vtx22/siemens-vehicle/README.md

# PCB | Siemens Projekt 2021/2022
Dokumentation für das PCB des Fahrzeugs, das im Rahmen der Projektarbeit der Siemens Ausbildung entstanden ist.
