vtx22/siemens-vehicle/Altium Projekt/SiemensKarre/Project Outputs for SiemensKarre/SiemensKarre.xlsx

Comment | Description | Designator | Footprint | LibRef | Quantity
220uF | Capacitor Polarised | C1, C3, C24 | CAPAE830X650N | EEE-FK1A221P | 3
10nF | Capacitor | C2, C4, C10, C21, C26, C29, C34 | CAPC2012 METRIC | CL21B104KACNNNC | 7
100nF | Capacitor | C5, C6, C11, C12, C13, C14, C19, C22, C27, C30, C31, C33, C36, C38, C42 | CAPC2012 METRIC | CL21B104KACNNNC | 15
22pF | Capacitor | C7, C8 | CAPC2012 METRIC | CL21B104KACNNNC | 2
1uF | Capacitor | C9 | CAPC2012 METRIC | CL21B104KACNNNC | 1
4.7uF | Capacitor | C15 | CAPC2012 METRIC | CL21B104KACNNNC | 1
10pF | Capacitor | C16, C17 | CAPC2012 METRIC | CL21B104KACNNNC | 2
10uF | Capacitor | C18, C20, C40 | CAPC2012 METRIC | CL21B104KACNNNC | 3
47uF | Capacitor | C23 | CAPC2012 METRIC | CL21B104KACNNNC | 1
120uF | Capacitor Polarised | C25 | CAPAE830X650N | EEE-FK1A221P | 1
330uF | Capacitor Polarised | C28 | CAPAE830X650N | EEE-FK1A221P | 1
1000uF | Capacitor Polarised | C32 | CAPAE830X650N | EEE-FK1A221P | 1
100uF | Capacitor Polarised | C35 | CAPAE830X650N | EEE-FK1A221P | 1
PDS1040L-13 | Diode | D1, D2, D3, D4, D5 | POWERDI5 | PDS1040L-13 | 5
1N5819 | Diode | D6 | SOD3716X145N | 1N5819HW-7-F | 1
PESD5V0U1BA,115 | Diode ESD (Bi-directional) | D7 | PESD1IVN27AX | PESD5V0U1BA,115 | 1
LM2678S-5.0_NOPB | Integrated Circuit | IC1 | TO127P1435X464-8N | LM2678S-5.0_NOPB | 1
STM32F103C8T6 | Integrated Circuit | IC2 | QFP50P900X900X160-48N | STM32F103C8T6TR | 1
AMS1117-3.3 | Integrated Circuit | IC3 | SOT229P700X180-4N | AMS1117-3.3 | 1
LM2596S-ADJ_NOPB | Integrated Circuit | IC4 | LM2596SXADJ | LM2596S-ADJ_NOPB | 1
LM2587S-ADJ | Integrated Circuit | IC5 | TO170P1435X465-6N | LM2587S-ADJ_NOPB | 1
DS18B20 | Integrated Circuit | IC6 | DS18B20TR | DS18B20+T&R | 1
INA226AIDGST | Integrated Circuit | IC7 | SOP50P490X110-10N | INA226AIDGST | 1
FT232RL | Integrated Circuit | IC8 | SOP65P778X200-28N | FT232RL | 1
BC846BLT1G | Integrated Circuit | IC10 | SOT96P237X111-3N | BC846BLT1G | 1
Battery IN | Connector | J1 | XT30PB | XT30PB | 1
To Motor PCB | Connector | J2 | XT30PB | XT30PB | 1
5V | Connector | J3, J4, J5 | 2 Pin Header BIG PADS | 2 Pin Header Big Pad | 3
ADJ | Connector | J6, J7 | 2 Pin Header BIG PADS | 2 Pin Header Big Pad | 2
BAT | Connector | J8 | 2 Pin Header BIG PADS | 2 Pin Header Big Pad | 1
24V | Connector | J9, J10 | 2 Pin Header BIG PADS | 2 Pin Header Big Pad | 2
Charger IN | Connector | J11 | 2 Pin Header BIG PADS | 2 Pin Header Big Pad | 1
Charger OUT | Connector | J12 | 2 Pin Header BIG PADS | 2 Pin Header Big Pad | 1
5V ON/OFF | Connector | J13 | 2 Pin Header BIG PADS | 2 Pin Header Big Pad | 1
UART1 | Connector | J14 | 2 Pin Header BIG PADS | 2 Pin Header Big Pad | 1
BOOT SELECT | Connector | J15 | HDRV3W64P0X254_1X3_762X254X869P | 61300311121 | 1
PROG | Connector | J16 | HDRV3W64P0X254_1X3_762X254X869P | 61300311121 | 1
UART3 | Connector | J17 | 2 Pin Header BIG PADS | 2 Pin Header Big Pad | 1
I2C1 | Connector | J18, J24 | 2 Pin Header BIG PADS | 2 Pin Header Big Pad | 2
LEDS1 | Connector | J19 | HDRV3W64P0X254_1X3_762X254X869P | 61300311121 | 1
ADCs | Connector | J20 | HDRV3W64P0X254_1X3_762X254X869P | 61300311121 | 1
USB Power | Connector | J21 | 875200010BLF | 87520-0010BLF | 1
Micro USB Port | Connector | J26 | 101041100001LF | Micro USB Port | 1
GPIOs | Connector | J28 | HDRV4W95P0X254_1X4_1016X254X854P | 61300411121 | 1
ULTRA1 | Connector | J29, J30 | HDRV4W95P0X254_1X4_1016X254X854P | 61300411121 | 2
VCC | Connector | J31 | 2 Pin Header BIG PADS | 2 Pin Header Big Pad | 1
Main Switch | Connector | J32 | 2 Pin Header BIG PADS | 2 Pin Header Big Pad | 1
G5NB-1A-E_5DC | Relay or Contactor | K1 | G5NB1A4DC5 | G5NB-1A-E_5DC | 1
SRP1270-100M | Inductor | L1 | INDPM137137X700N | SRP1270-100M | 1
39nH | Chip Bead, 100 MHz, 5 A, -40 to 125 degC, 2-Pin SMD (0805), RoHS, Tape and Reel | L2 | LIRD-LI0805H151R-10-2_V | CMP-2000-06404-1 | 1
IHLP6767GZER470M11 | Inductor | L3, L4 | INDPM172172X700N | IHLP6767GZER470M11 | 2
5V Green | SMD mono-color Chip LED, WL-SMCW, Green | LED1 | 1206_A | CMP-1426-00014-1 | 1
12V Green | SMD mono-color Chip LED, WL-SMCW, Green | LED2 | 1206_A | CMP-1426-00014-1 | 1
24V Green | SMD mono-color Chip LED, WL-SMCW, Green | LED3 | 1206_A | CMP-1426-00014-1 | 1
BAT Yell | SMD mono-color Chip LED, WL-SMCW, Green | LED4 | 1206_A | CMP-1426-00014-1 | 1
Stat1 | SMD mono-color Chip LED, WL-SMCW, Green | LED5 | 1206_A | CMP-1426-00014-1 | 1
Stat2 | SMD mono-color Chip LED, WL-SMCW, Green | LED6 | 1206_A | CMP-1426-00014-1 | 1
BAT Red | SMD mono-color Chip LED, WL-SMCW, Green | LED7, LED8 | 1206_A | CMP-1426-00014-1 | 2
Green | SMD mono-color Chip LED, WL-SMCW, Green | LED11 | 1206_A | CMP-1426-00014-1 | 1
190 | Resistor | R1 | RESC2012X65N | Res 0805 | 1
890 | Resistor | R2 | RESC2012X65N | Res 0805 | 1
2090 | Resistor | R3 | RESC2012X65N | Res 0805 | 1
1510 | Resistor | R4, R5, R6 | RESC2012X65N | Res 0805 | 3
47k | Resistor | R7, R11 | RESC2012X65N | Res 0805 | 2
15k | Resistor | R8, R41 | RESC2012X65N | Res 0805 | 2
2k | Resistor | R9 | RESC2012X65N | RMCF0805ZT0R00 | 1
24k | Resistor | R10 | RESC2012X65N | Res 0805 | 1
7.5k | Resistor | R12, R16, R17, R27 | RESC2012X65N | Res 0805 | 4
3.9k | Resistor | R13, R46 | RESC2012X65N | Res 0805 | 2
200k | Resistor | R14 | RESC2012X65N | RMCF0805ZT0R00 | 1
9.1k | Resistor | R15 | RESC2012X65N | Res 0805 | 1
10k | Resistor | R18, R20, R21, R24 | RESC2012X65N | RMCF0805ZT0R00 | 4
330 | Resistor | R19 | RESC2012X65N | RMCF0805ZT0R00 | 1
0 | Resistor | R22, R37 | RESC2012X65N | RMCF0805ZT0R00 | 2
390 | Resistor | R23 | RESC2012X65N | RMCF0805ZT0R00 | 1
4.7k | Resistor | R25, R26, R28, R32 | RESC2012X65N | RMCF0805ZT0R00 | 4
350 | Resistor | R29 | RESC2012X65N | RMCF0805ZT0R00 | 1
100 | Resistor | R30 | RESC2012X65N | RMCF0805ZT0R00 | 1
10m | Resistor | R31 | RESC5025X88N | WSL2010R0100FEA18 | 1
28k | Resistor | R33 | RESC2012X65N | Res 0805 | 1
1.5k | Resistor | R34, R44, R45 | RESC2012X65N | Res 0805 | 3
2.94k | Resistor | R35 | RESC2012X65N | Res 0805 | 1
500 | Resistor | R38, R39 | RESC2012X65N | RMCF0805ZT0R00 | 2
1k | Resistor | R42 | RESC2012X65N | Res 0805 | 1
300 | Resistor | R43 | RESC2012X65N | Res 0805 | 1
SMDButton |  | SW1 | SMD-Button-3*6mm | SMDButton-3*6mm | 1
10kOhm Trimmer | Variable Resistor | VR1 | 3296W-1 | 3296W-1-103LF | 1
MC-306 32.768kHz | Crystal or Oscillator | Y1 | MC306327680KA3ROHS | MC-306_32.7680K-A3_ROHS | 1
FOXSDLF/080-20 | Resistance Weld Crystal, 8 MHz, +/- 30 ppm, -20 to 70 degC, 2-Pin SMD, RoHS, Tape and Reel | Y2 | FOX-HC49SDLF_V | CMP-2100-03639-1 | 1
