vtx22/siemens-vehicle/Altium Projekt/SiemensKarre/Outline.dxf

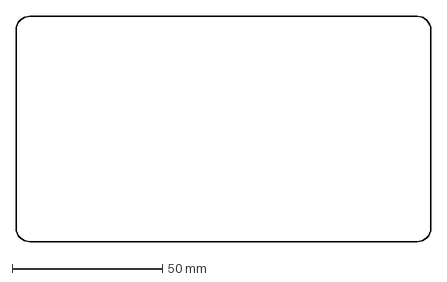
[picture p1: CAD file, 2022-01-15]
Altium Projekt/SiemensKarre/Outline.dxf
138.0 x 75.0 mm
