vtx22/siemens-vehicle/Dokumentation/Schematics.pdf

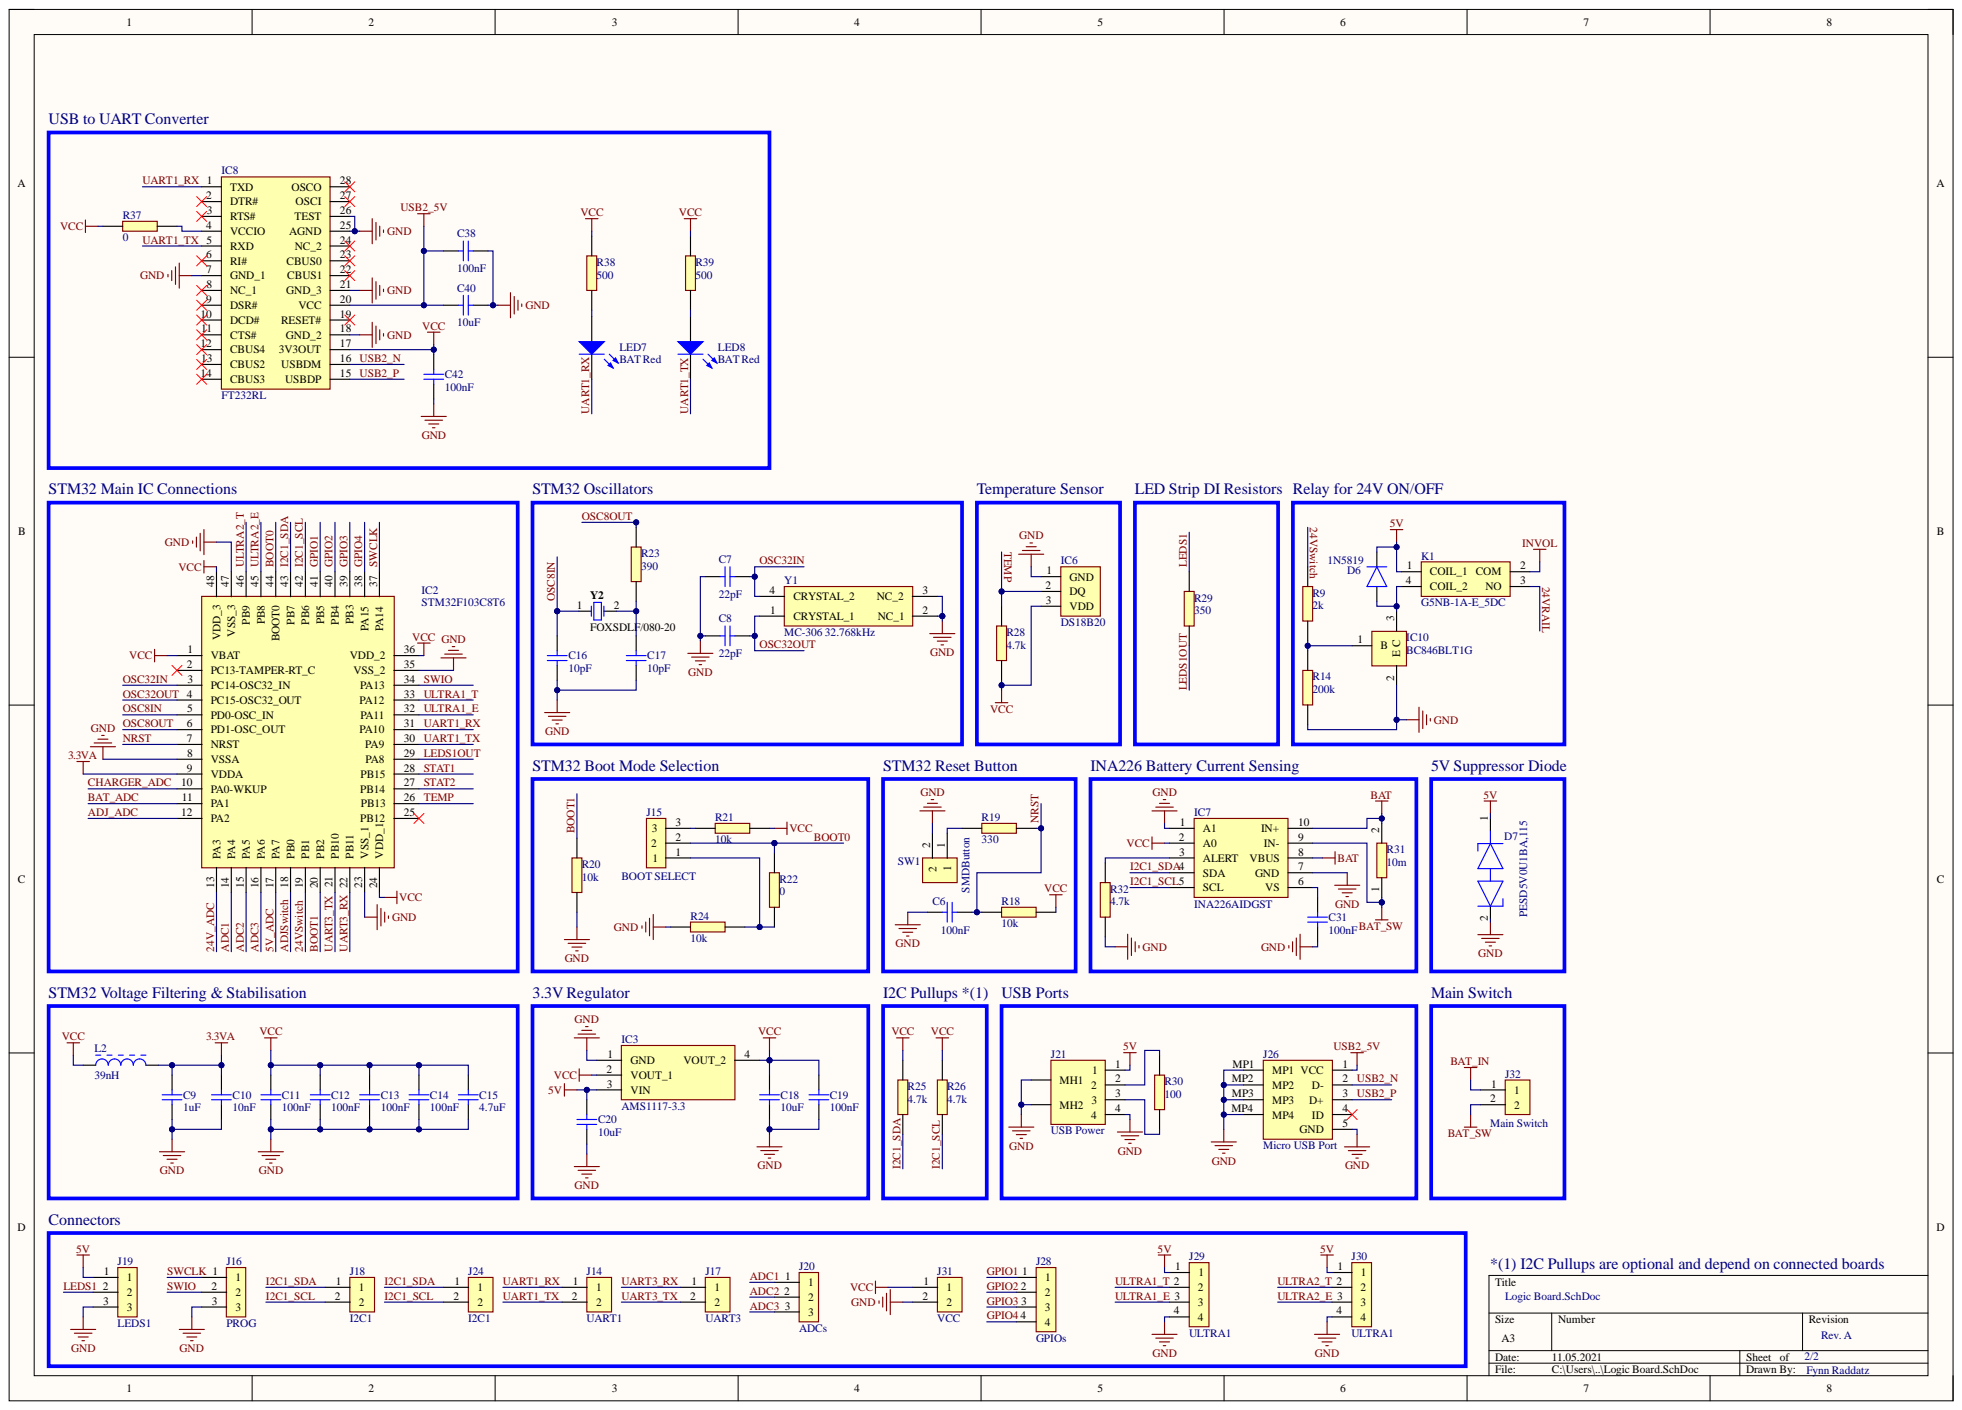
[picture p2: page 1]

USB to UART Converter

LED Strip DI Resistors

Relay for 24V ON/OFF

*(1) I2C Pullups are optional and depend on connected boards
Title
Logic Board.SchDoc

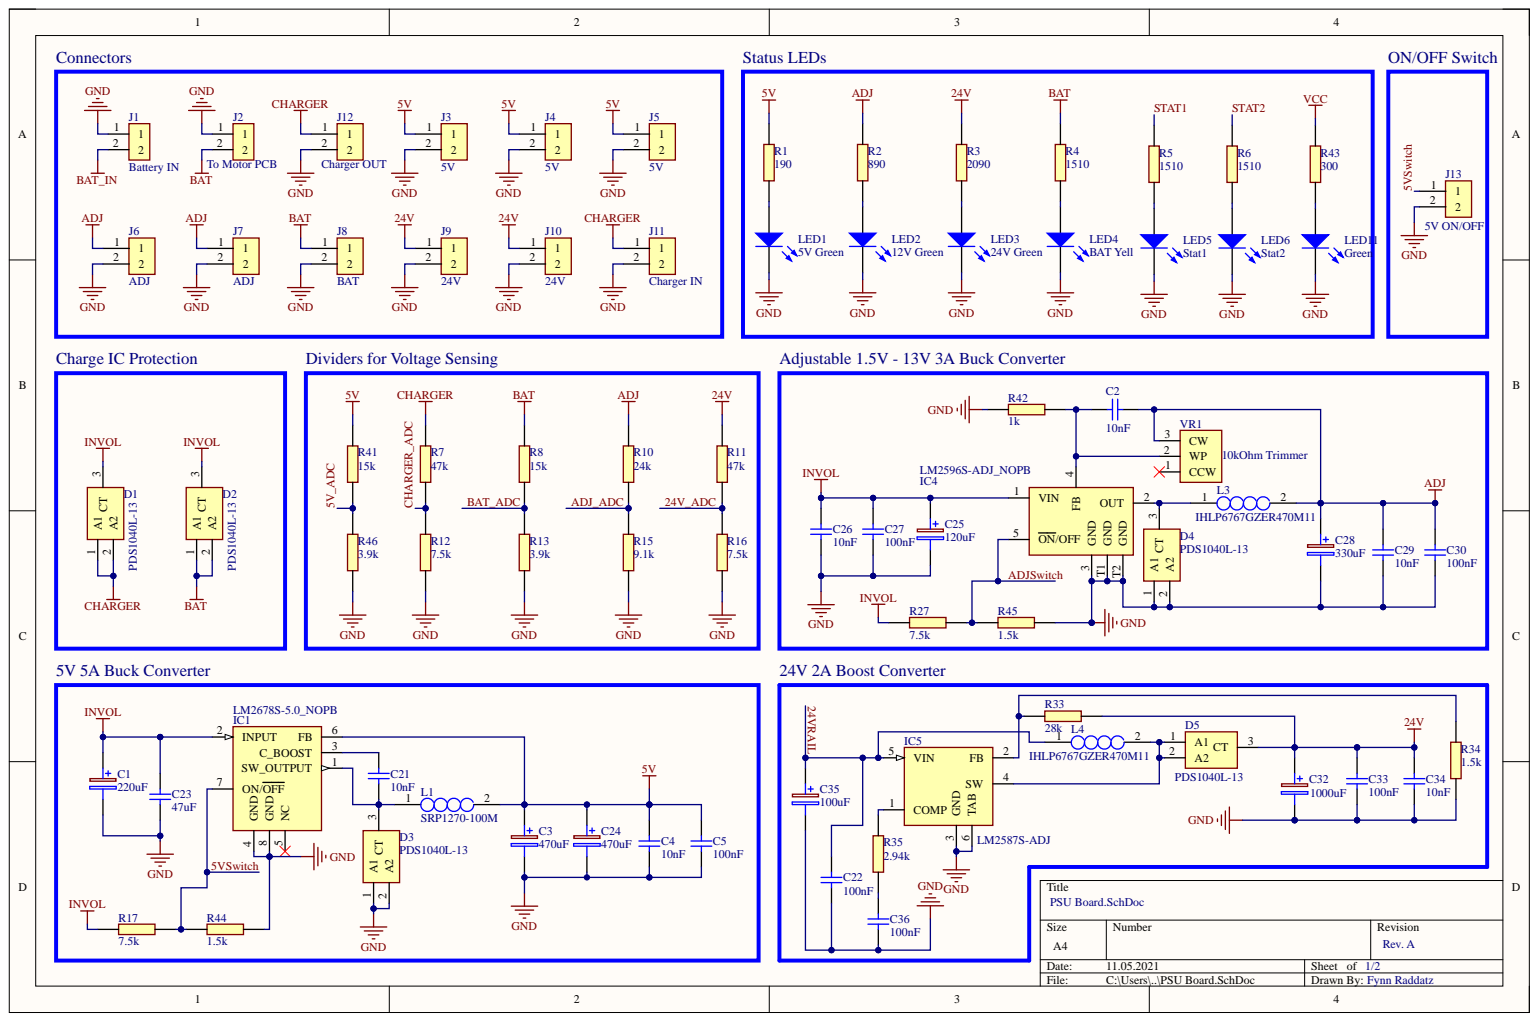
[picture p3: page 2]

Dividers for Voltage Sensing

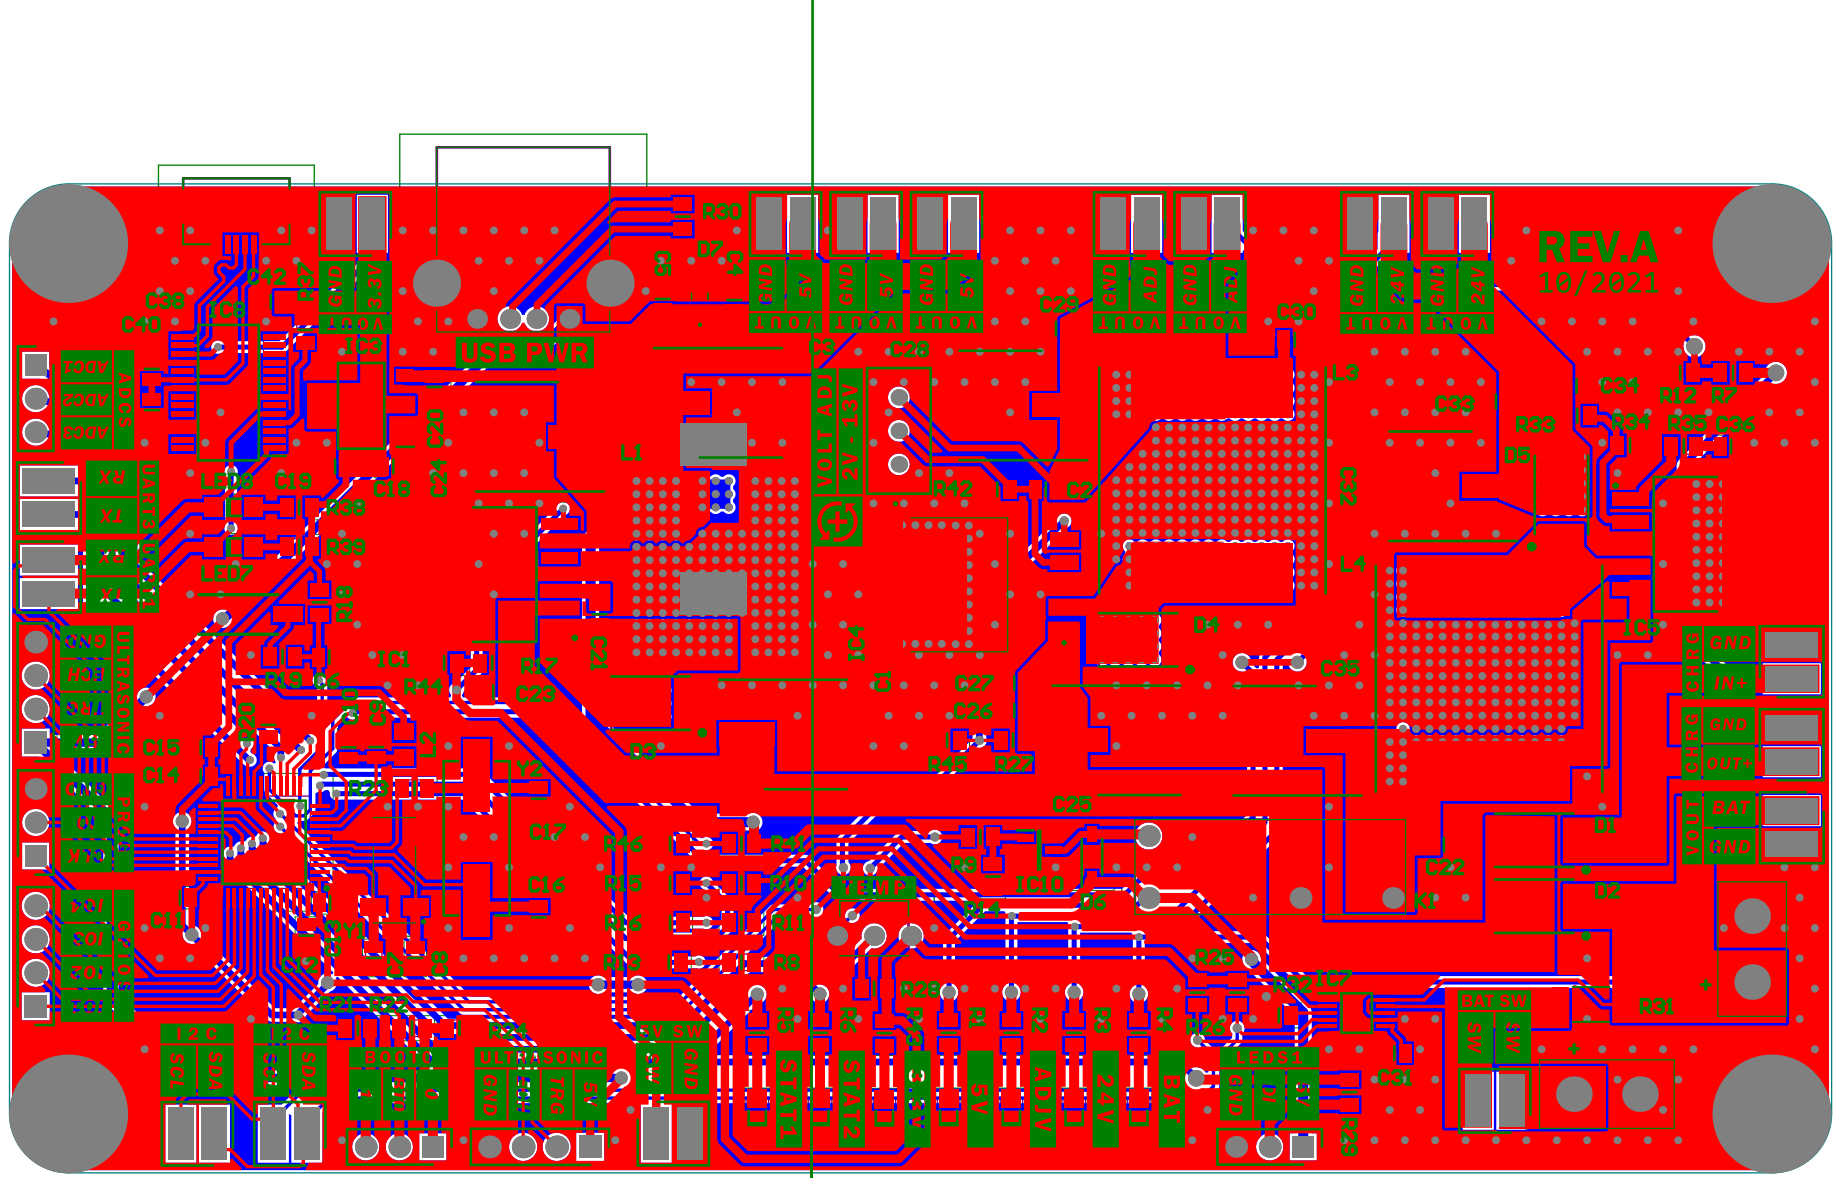
[picture p4: page 3]
