vtx22/siemens-vehicle/Dokumentation/Technische Zeichnung.pdf

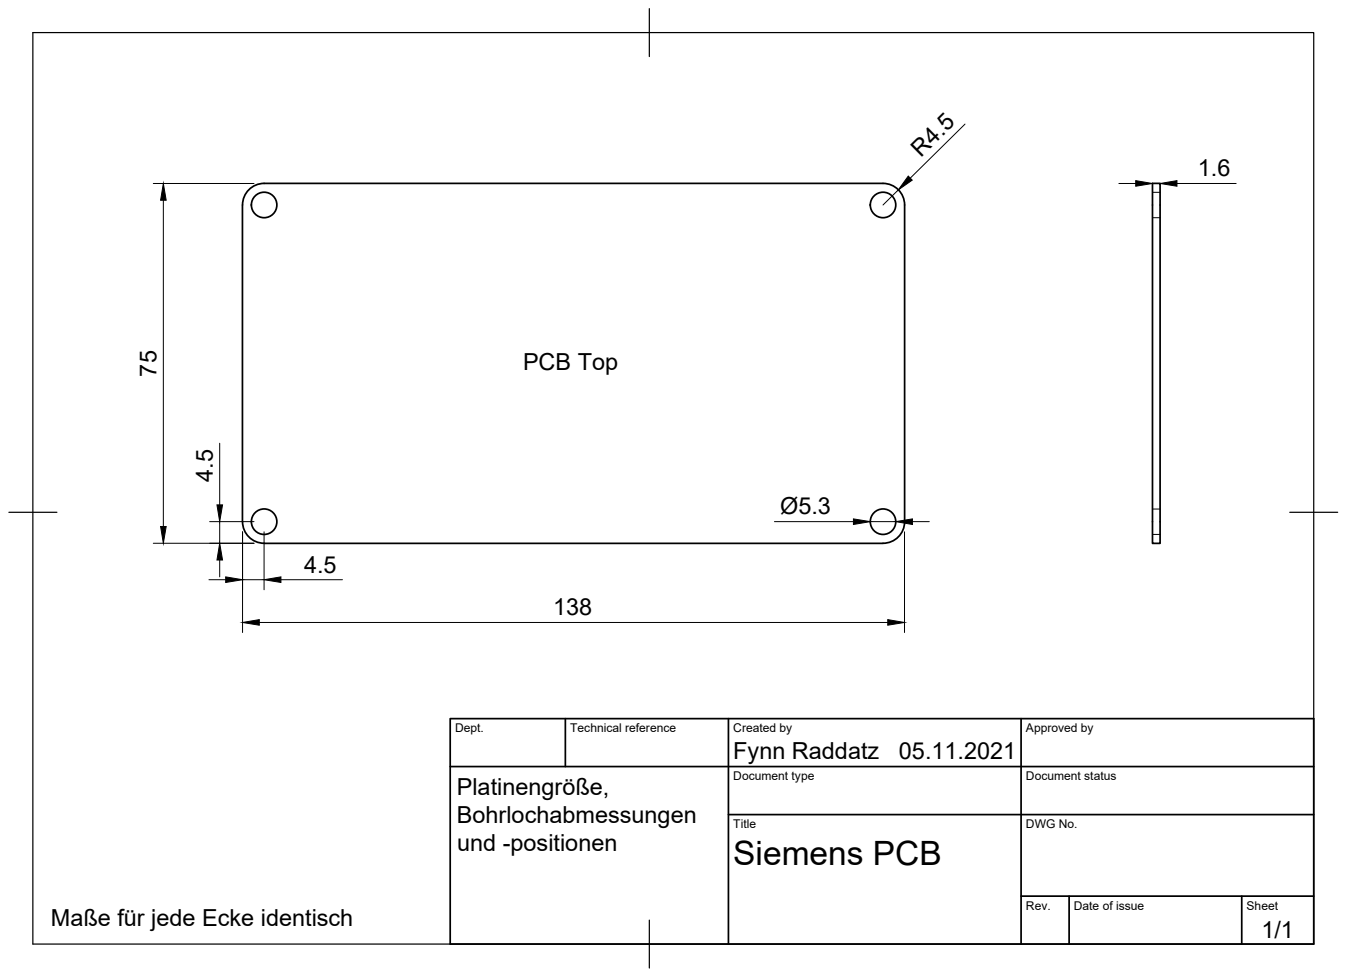
[picture p5: page 1]
Fynn Raddatz 75; PCB Top

Dept. | Technical reference | Created by 05.11.2021 | Approved by

Platinengröße, Bohrlochabmessungen und -positionen | | Document type | Document status

Title Siemens PCB | DWG No.

Maße für jede Ecke identisch

Rev. | Date of issue | Sheet 1/1
