vtx22/siemens-vehicle/(list of files, drawings)

Other design files:
Altium Projekt/SiemensKarre/Logic Board.SchDoc
Altium Projekt/SiemensKarre/PSU Board.SchDoc
Altium Projekt/SiemensKarre/SiemensKarre.PrjPcb
