vtx22/siemens-vehicle/CubeIDE Projekt/SiemensKarre.ioc

Mcu.UserName=STM32F103C8Tx
PA0-WKUP.Signal=ADCx_IN0
PA1.Signal=ADCx_IN1
PA10.Signal=USART1_RX
PA11.Signal=GPIO_Input
PA12.Signal=GPIO_Output
PA13.Signal=SYS_JTMS-SWDIO
PA14.Signal=SYS_JTCK-SWCLK
PA15.Signal=GPIO_Output
PA2.Signal=ADCx_IN2
PA3.Signal=ADCx_IN3
PA4.Signal=ADCx_IN4
PA5.Signal=ADCx_IN5
PA6.Signal=ADCx_IN6
PA7.Signal=ADCx_IN7
PA8.GPIO_Label=LEDS
PA8.Signal=GPIO_Output
PA9.Signal=USART1_TX
PB0.Signal=GPIO_Output
PB1.Signal=GPIO_Output
PB10.Signal=USART3_TX
PB11.Signal=USART3_RX
PB13.Signal=GPIO_Output
PB14.Signal=GPIO_Output
PB15.Signal=GPIO_Output
PB3.Signal=GPIO_Output
PB4.Signal=S_TIM3_CH1
PB5.Signal=S_TIM3_CH2
PB6.Signal=I2C1_SCL
PB7.Signal=I2C1_SDA
PB8.Signal=GPIO_Input
PB9.Signal=GPIO_Output
PC13-TAMPER-RTC.Signal=GPIO_Output
PC14-OSC32_IN.Signal=RCC_OSC32_IN
PC15-OSC32_OUT.Signal=RCC_OSC32_OUT
PD0-OSC_IN.Signal=RCC_OSC_IN
PD1-OSC_OUT.Signal=RCC_OSC_OUT
