vtx22/siemens-vehicle/(commit log)

2022-01-15 Added Software Project
    [SiemensKarre Debug.cfg]
2022-01-15 Working Sensors
2022-01-17 Update Repo
    [SiemensKarre Debug.cfg, UART Protocol.xlsx]
2022-01-25 no idea
    [SiemensKarre Debug.cfg]
2022-01-25 Added LED Blink Structure
2022-01-27 Added Manual LED via Ros
